daveho/eeprog/hw/eeprog.pdf

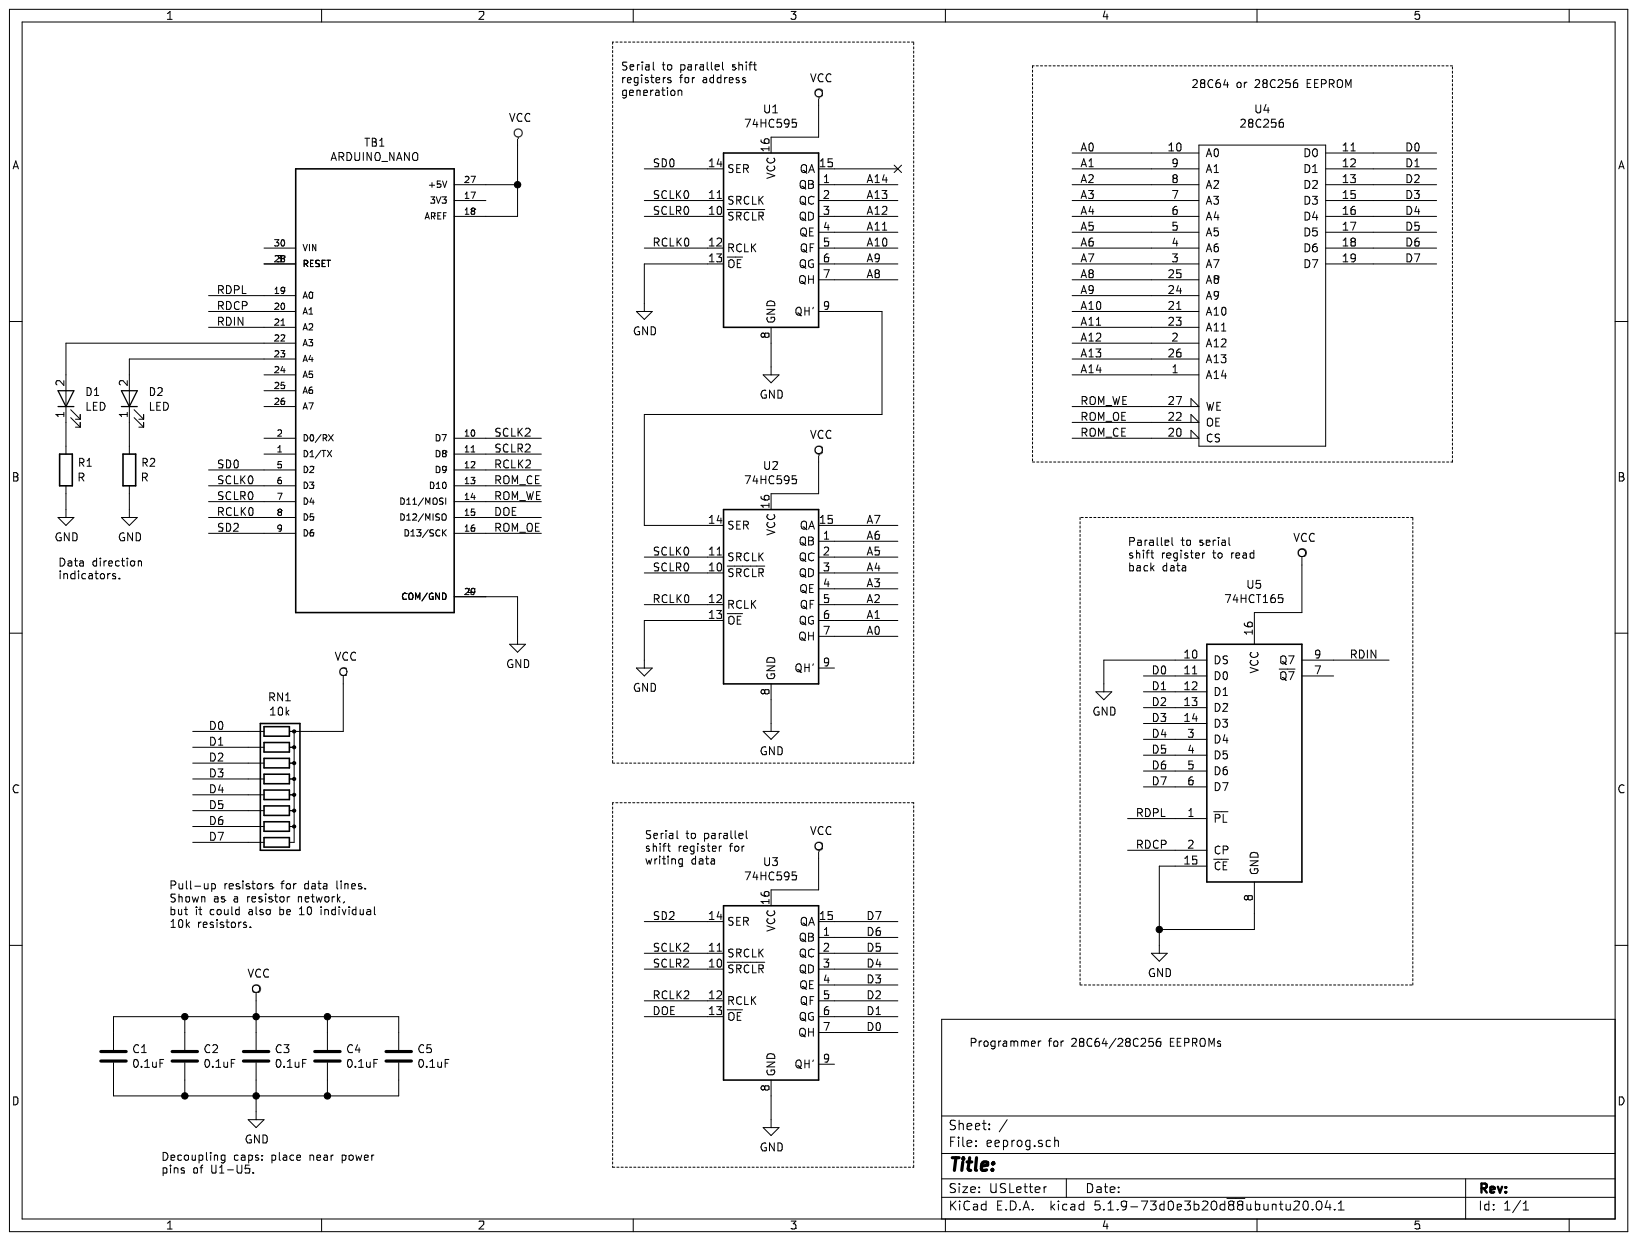
[picture p2: page 1]
