daveho/eeprog/(commit log)

2019-06-04 initial version of circuit
    [eeprog.kicad_pcb, eeprog.sch]
2019-06-05 fix inputs to 74HC165
    [eeprog.sch]
2019-06-05 eliminate AOE, rename signals for clarity
    AOE is unnecessary because the address outputs should
    always be active.
    Renamed some signals on the ROM and the 74HC165 to
    give them a common prefix.
    [eeprog.sch]
2019-06-06 minor tweak to error handling
    [eeprog.ino]
2019-06-07 bugfixes, implement reading data
    [eeprog.ino]
2019-06-08 working on byte writes
    Doesn't seem to be working at the moment: it's
    possible that the chip I'm trying to program has
    write protection enabled.
    [eeprog.ino]
2019-06-08 add pull-up resistors on data lines
    This ensures that the inputs to the EEPROM and
    74HC165 are never floating.
    [eeprog.sch]
2019-06-08 fix delay to wait for write cycle completion
    Also, simplify data-writing code slightly.
    [eeprog.ino]
2019-06-09 add indicator LEDs and decoupling caps
    [eeprog.sch]
2019-06-09 add indicator LEDs for data direction
2019-06-12 started to flesh out option handling, control flow
2019-06-14 started to implement communication with Arduino
2019-06-15 reading works; print info banner with website URL
    At this point the programmer and the host utility appear
    to be functional! Tested with AT28C256; need to
    test with other EEPROM chips.
2019-07-27 add delays when pulsing '165 to latch read data
    Was having some trouble reading back data from the
    '165 shift register. Added some delays when clocking
    it. We'll see if that fixes the problem.
    Also, changed the '165 shift register device name
    from 74HC165 to 74HCT165 in the schematic. HCT
    logic is a better choice, since I have observed
    memory devices outputting TTL level signals, which
    might not reliably drive the inputs of 74HC chips.
    [eeprog.sch]
2021-03-03 pdf version of schematic
